wormyrocks/Harrison145/Harrison145_Antenna/Sprite-0001.png

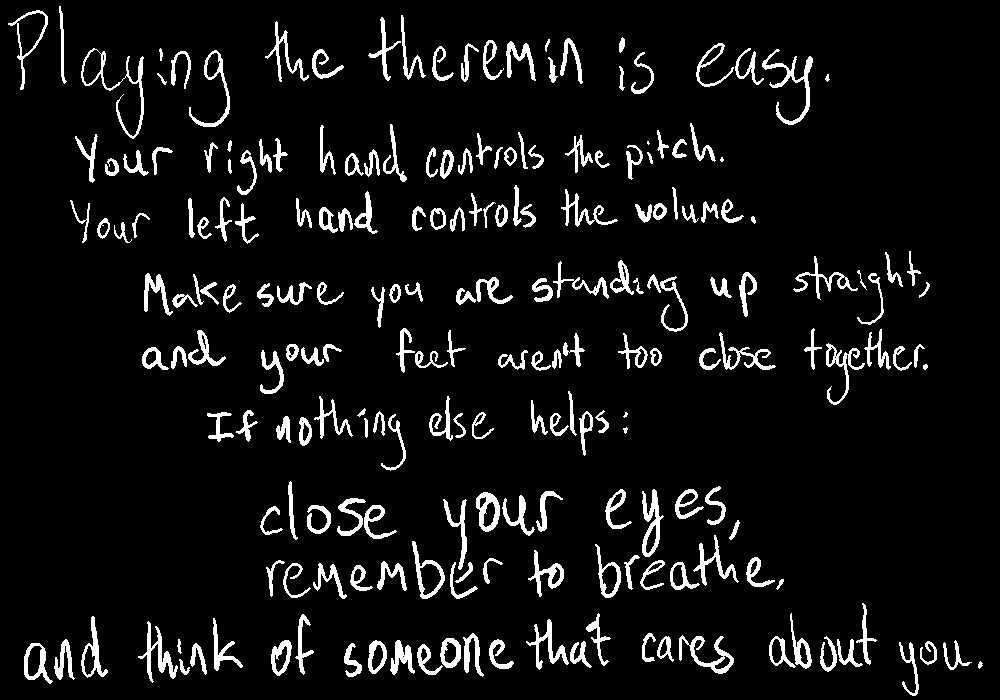
Harrison145_Antenna/Sprite-0001.png
