wormyrocks/Harrison145/ngspice/waveforms/breadboard-aircoil.png

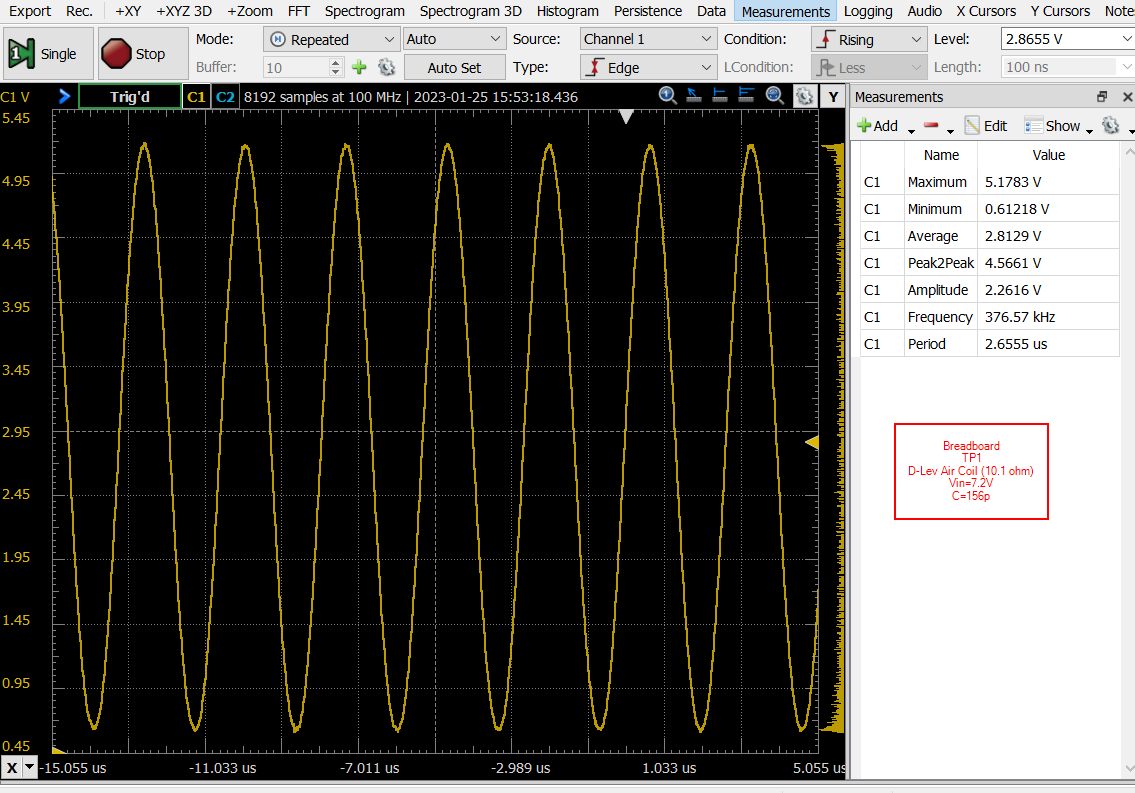
ngspice/waveforms/breadboard-aircoil.png
