wormyrocks/Harrison145/ngspice/waveforms/breadboard-coilcraft-shielded.png

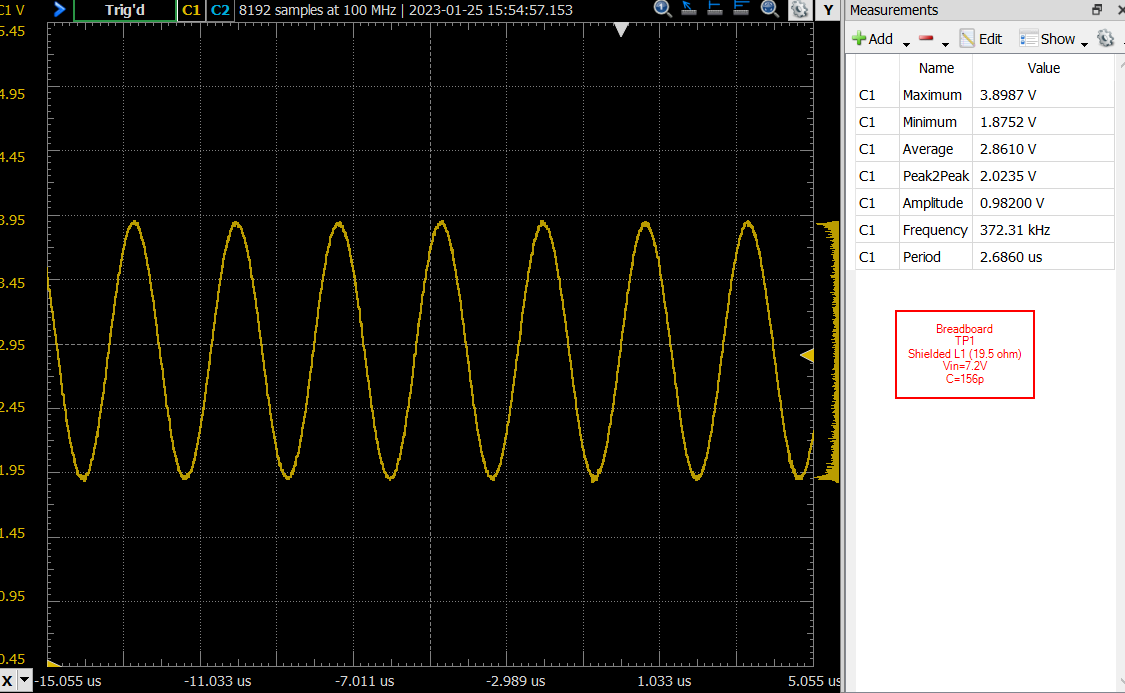
ngspice/waveforms/breadboard-coilcraft-shielded.png
