wormyrocks/Harrison145/ngspice/waveforms/pcb-coilcraft-shielded.png

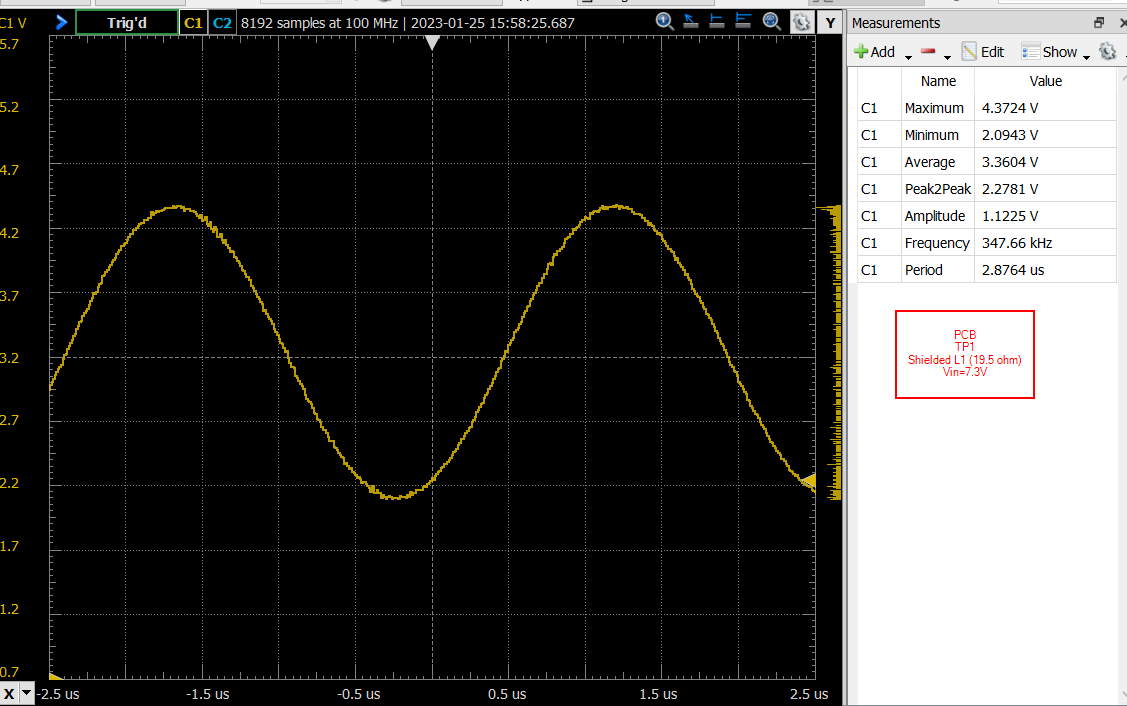
ngspice/waveforms/pcb-coilcraft-shielded.png
