wormyrocks/Harrison145/Harrison145_Main/MouserBOM.xls

Mfr Part Number (Input) | Manufacturer Part Number | Mouser Part Number | Manufacturer Name | Description | Quantity 1 | Unit Price 1 | Quantity 2 | Unit Price 2 | Quantity 3 | Unit Price 3 | Quantity 4 | Unit Price 4 | Quantity 5 | Unit Price 5 | Order Quantity | Order Unit Price | Min./Mult. | Availability | Lead Time in Days | Lifecycle | NCNR | RoHS | Pb Free | Package Type | Datasheet URL | Product Image | Design Risk
 |  | 74-TMCP1E105KTRF |  | C1, C2, C18, C30, C31, C33, C41 | 7
 |  | 80-C0603C101K8RAUTO |  | C3, C29 | 2
 |  | 80-C0603C100K3RAUTO |  | C4, C5, C15, C17, C19, C20, C26, C28 | 8
 |  | 598-MC12FA151J-F |  | C6, C16 | 2
 |  | 768-JZ400 |  | C7, C25 | 2
 |  | 80-C0603C103K2REAUTO |  | C8, C9, C11, C12, C13 | 5
 |  | 80-T489A106K10ATA2K2 |  | C10, C37, C38, C40 | 4
 |  | 5982-08-100V5.0-F |  | C14, C24 | 2
 |  | 598-MC12CD100D-TF |  | C14_TEST1, C24_TEST1 | 2
 |  | 598-MC18FD331J-TF |  | C21, C27 | 2
 |  | 80-C603C104K5RAC3121 |  | C22, C23, C34, C35 | 4
 |  | 667-EEF-KX0E221RE |  | C32, C39 | 2
 |  | 581-TACL474K010X |  | C36 | 1
 |  | 637-SM4001 |  | CR1, CR2, CR4, CR5, CR6 | 5
 |  | 512-1N914BWT |  | CR3 | 1
 |  | 710-150060GS75000 |  | D1 | 1
 |  | 807-5022R-102J |  | L1, L2, L3, L4 | 4
 |  | 726-MMBT3906LT1 |  | Q1, Q2, Q6, Q7, Q11, Q12, Q16 | 7
 |  | 106-SMP5484 |  | Q3, Q5, Q8, Q10, Q13 | 5
 |  | 726-MMBT3904LT1 |  | Q4, Q9, Q14, Q15 | 4
 |  | 603-RC0603FR-103K3L |  | R1, R24, R36 | 3
 |  | 603-RC0603FR-0722KL |  | R2, R35 | 2
 |  | 603-RC0603FR-0710KL |  | R3, R25, R37 | 3
 |  | 603-RC0603FR-07100KL |  | R4 | 1
 |  | 603-AC0603FR-074M7L |  | R5, R20, R27, R33 | 4
 |  | 603-RC0603FR-072M7L |  | R6, R21, R28, R34 | 4
 |  | 603-RC0603FR-102K2L |  | R7, R14, R15, R19, R29, R30, R31 | 7
 |  | 603-AC0603FR-071ML |  | R8, R9, R10, R39, R40, R42 | 6
 |  | 603-RC0603FR-0710KL |  | R11, R17 | 2
 |  | 603-RC0603FR-13150KL |  | R12 | 1
 |  | 603-RC0603FR-07100KL |  | R13, R23, R38, R41, R44, R48, R55 | 7
 |  | 603-RC0603FR-071KP |  | R16, R58 | 2
 |  | 603-RC0603FR-13220KL |  | R18 | 1
 |  | 603-RC0603FR-0722KL |  | R22, R49, R52 | 3
 |  | 603-RC0603FR-0768KL |  | R26 | 1
 |  | 603-RC0603FR-1333KL |  | R32, R45 | 2
 |  | 603-RC0603FR-07680RL |  | R43 | 1
 |  | 603-RC0603FR-13220RL |  | R46 | 1
 |  | 603-RC0603FR-1333RL |  | R47 | 1
 |  | 603-RC0603FR-104K7L |  | R50, R51 | 2
 |  | 603-SR0603FR-7T10RL |  | R53, R54 | 2
 |  | 603-RC0603FR-103K3L |  | R56 | 1
 |  | 603-RC0603FR-073K92L |  | R57 | 1
 |  | 652-PTV09A-3015FB103 |  | RV1, RV2 | 2
 |  | 534-5002 |  | TP1, TP2, TP3, TP4, TP5, TP6, TP7, TP8 | 8
 |  | 511-LDK320M-R |  | U1 | 1
 |  | 511-LDK320M-R |  | U1 | 1
