wormyrocks/Harrison145/Harrison145_Antenna/Harrison145_Antenna.kicad_pcb

## KiCad design Harrison145_Antenna/Harrison145_Antenna.kicad_pcb (2023-02-07)

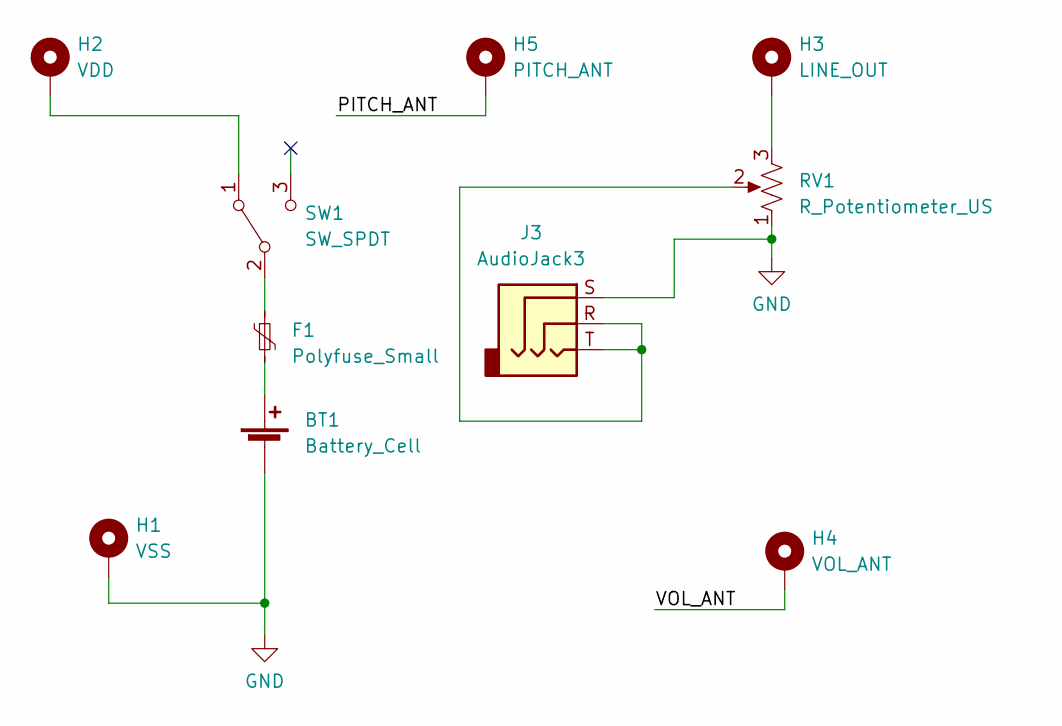
[picture p5: schematic Harrison145_Antenna.kicad_sch]

Parts:
BT1: Battery_Cell; 9V_Bat
F1: Polyfuse_Small; Fuse_1812_4532Metric_Pad1.30x3.40mm_HandSolder
H1: VSS; SMTSO-M4
H2: VDD; SMTSO-M4
H3: LINE_OUT; SMTSO-M4
H4: VOL_ANT; SMTSO-M4
H5: PITCH_ANT; SMTSO-M4
J3: AudioJack3; Jack_3.5mm_CUI_SJ-3523-SMT_Horizontal
RV1: R_Potentiometer_US; PTV09A3015FB103
SW1: SW_SPDT; CSS1210TB

Connections:
/PITCH_ANT: H5.1
/VOL_ANT: H4.1
GND: BT1.2 (-), H1.1, J3.S, RV1.1
unnamed: BT1.1 (+), F1.2
unnamed: H3.1, RV1.3
unnamed: J3.R, J3.T, RV1.2
unnamed: H2.1, SW1.1 (A)
unnamed: F1.1, SW1.2 (B)

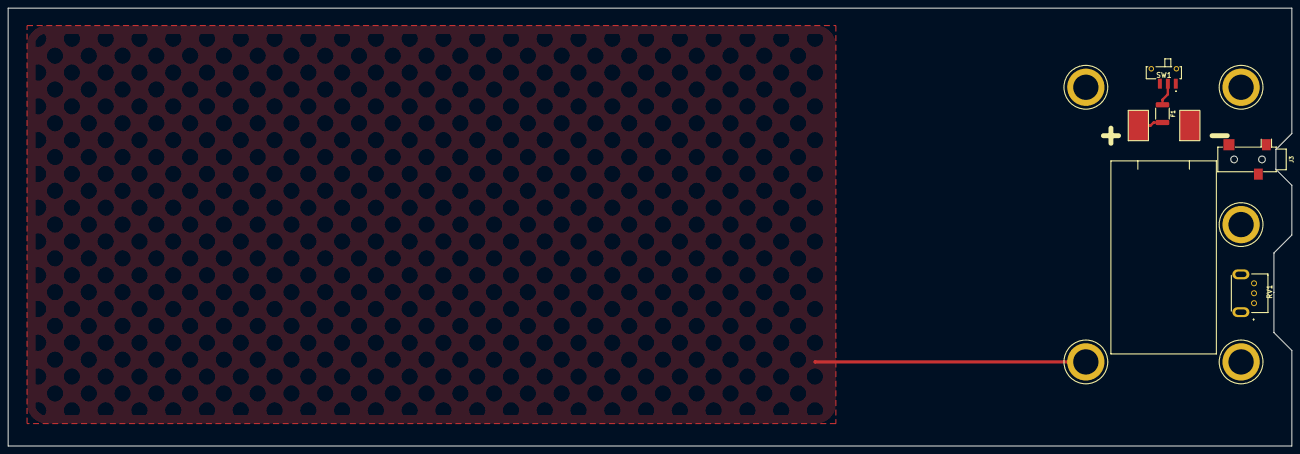
[picture p6: board Harrison145_Antenna.kicad_pcb from above]

Board: 2 copper layers, 322.5 x 110.0 mm, 10 parts (0 on the bottom side), 6 nets.
