wormyrocks/Harrison145/Harrison145_Main_Rev2/Harrison145.kicad_pcb

## KiCad design Harrison145_Main_Rev2/Harrison145.kicad_pcb (2023-01-10)

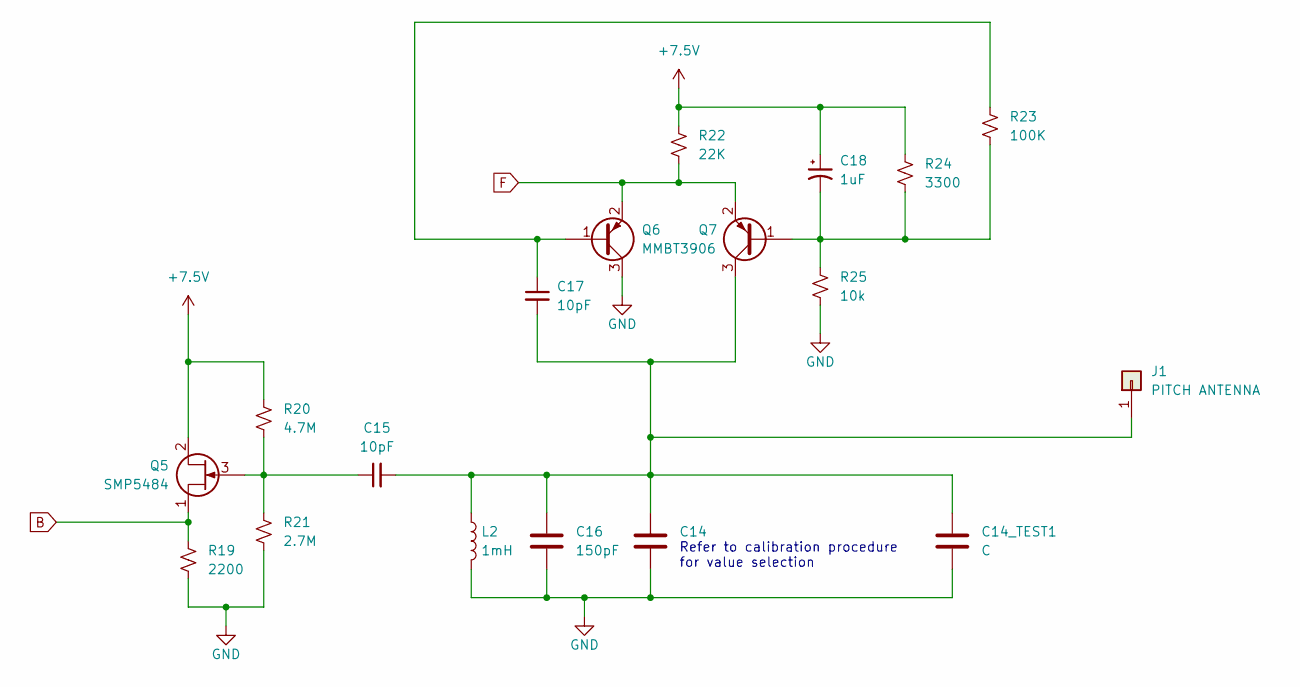
[picture p7: schematic VarOsc.kicad_sch]

Parts:
C14: C_Mica; C_0805_2012Metric_Pad1.18x1.45mm_HandSolder
C14_TEST1: C; C_Disc_D3.0mm_W1.6mm_P2.50mm
C15, C17: 10pF; C_0603_1608Metric
C16: 150pF; C_1210_3225Metric_Pad1.33x2.70mm_HandSolder
C18: 1uF; CP_EIA-2012-12_Kemet-R_Pad1.30x1.05mm_HandSolder
J1: PITCH ANTENNA; MountingHole_4.3mm_M4_Pad_Via
L2: 1mH; L_1812_4532Metric
Q5: SMP5484; SOT-23
Q6, Q7: MMBT3906; SOT-23
R19: 2200; R_0603_1608Metric
R20: 4.7M; R_0603_1608Metric
R21: 2.7M; R_0603_1608Metric
R22: 22K; R_0603_1608Metric
R23: 100K; R_0603_1608Metric
R24: 3300; R_0603_1608Metric
R25: 10k; R_0603_1608Metric

Connections:
+7.5V: C18.1, Q5.2 (D), R20.1, R22.1, R24.1; also elsewhere on the board
B: Q5.1 (S), R19.1; also elsewhere on the board
F: Q6.2 (E), Q7.2 (E), R22.2; also elsewhere on the board
GND: C14.2, C14_TEST1.2, C16.2, L2.2, Q6.3 (C), R19.2, R21.2, R25.2; also elsewhere on the board
unnamed: C14.1, C14_TEST1.1, C15.2, C16.1, C17.2, J1.1, L2.1, Q7.3 (C)
unnamed: C15.1, Q5.3 (G), R20.2, R21.1
unnamed: C17.1, Q6.1 (B), R23.1
unnamed: C18.2, Q7.1 (B), R23.2, R24.2, R25.1

Notes on the sheet:
Refer to calibration procedure for value selection

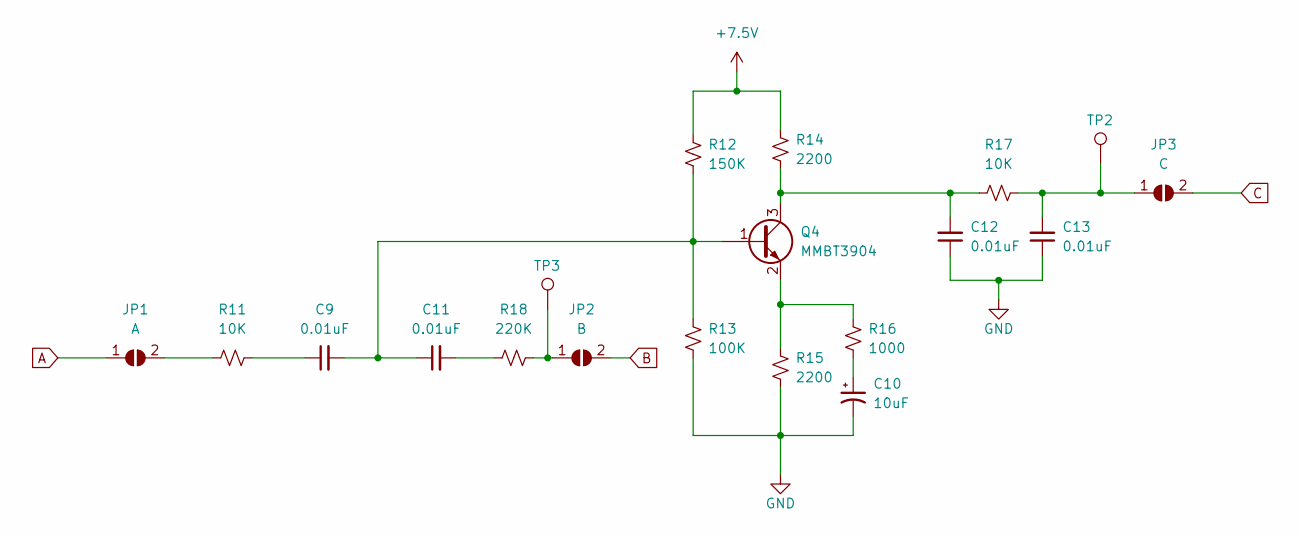
[picture p8: schematic mixer.kicad_sch]

Parts:
C9, C11, C12, C13: 0.01uF; C_0603_1608Metric
C10: 10uF; CP_EIA-3216-18_Kemet-A
JP1: A; SolderJumper-2_P1.3mm_Open_RoundedPad1.0x1.5mm
JP2: B; SolderJumper-2_P1.3mm_Open_RoundedPad1.0x1.5mm
JP3: C; SolderJumper-2_P1.3mm_Open_RoundedPad1.0x1.5mm
Q4: MMBT3904; SOT-23
R11, R17: 10K; R_0603_1608Metric
R12: 150K; R_0603_1608Metric
R13: 100K; R_0603_1608Metric
R14, R15: 2200; R_0603_1608Metric
R16: 1000; R_0603_1608Metric
R18: 220K; R_0603_1608Metric
TP2, TP3: TestPoint; TestPoint_Loop_D1.80mm_Drill1.0mm_Beaded

Connections:
+7.5V: R12.2, R14.2; also elsewhere on the board
A: JP1.1 (A); also elsewhere on the board
B: JP2.2 (B); also elsewhere on the board
C: JP3.2 (B); also elsewhere on the board
GND: C10.2, C12.1, C13.1, R13.1, R15.1; also elsewhere on the board
unnamed: C9.1, R11.2
unnamed: C10.1, R16.1
unnamed: C11.2, R18.1
unnamed: JP1.2 (B), R11.1
unnamed: JP2.1 (A), R18.2, TP3.1
unnamed: C13.2, JP3.1 (A), R17.2, TP2.1
unnamed: C9.2, C11.1, Q4.1 (B), R12.1, R13.2
unnamed: C12.2, Q4.3 (C), R14.1, R17.1
unnamed: Q4.2 (E), R15.2, R16.2

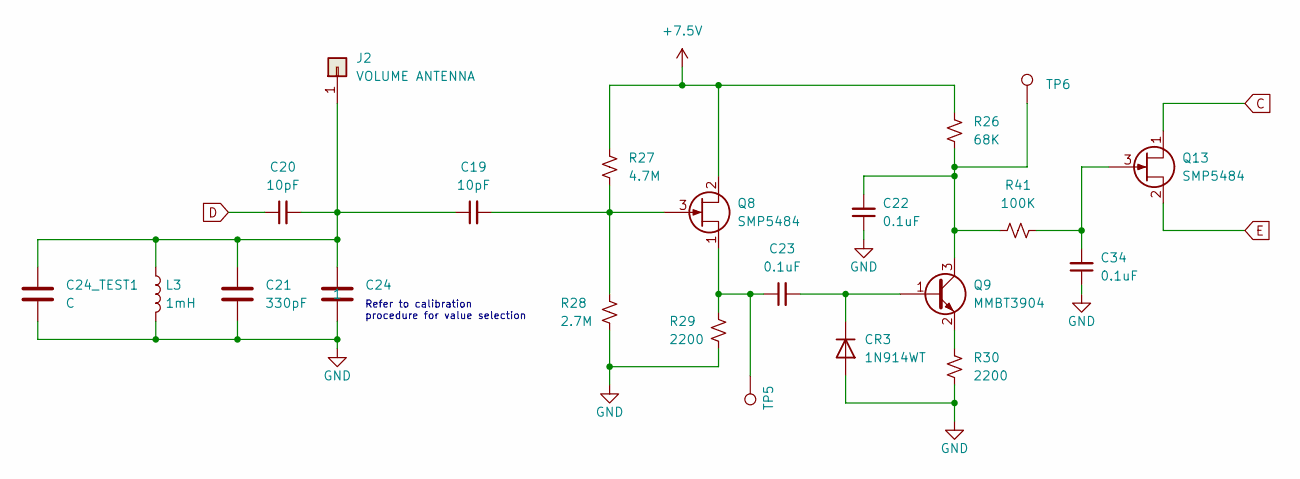
[picture p9: schematic VolProcessor.kicad_sch]

Parts:
C19, C20: 10pF; C_0603_1608Metric
C21: 330pF; C_1812_4532Metric_Pad1.57x3.40mm_HandSolder
C22, C23, C34: 0.1uF; C_0603_1608Metric
C24: C_Mica; C_0805_2012Metric_Pad1.18x1.45mm_HandSolder
C24_TEST1: C; C_Disc_D3.0mm_W1.6mm_P2.50mm
CR3: 1N914WT; D_SOD-523
J2: VOLUME ANTENNA; MountingHole_4.3mm_M4_Pad_Via
L3: 1mH; L_1812_4532Metric
Q8, Q13: SMP5484; SOT-23
Q9: MMBT3904; SOT-23
R26: 68K; R_0603_1608Metric
R27: 4.7M; R_0603_1608Metric
R28: 2.7M; R_0603_1608Metric
R29, R30: 2200; R_0603_1608Metric
R41: 100K; R_0603_1608Metric
TP5, TP6: TestPoint; TestPoint_Loop_D1.80mm_Drill1.0mm_Beaded

Connections:
+7.5V: Q8.2 (D), R26.1, R27.1; also elsewhere on the board
C: Q13.1 (S); also elsewhere on the board
D: C20.1; also elsewhere on the board
E: Q13.2 (D); also elsewhere on the board
GND: C21.2, C22.1, C24.2, C24_TEST1.2, C34.1, CR3.2 (A), L3.2, R28.2, R29.2, R30.2; also elsewhere on the board
unnamed: C23.2, CR3.1 (K), Q9.1 (B)
unnamed: C19.1, C20.2, C21.1, C24.1, C24_TEST1.1, J2.1, L3.1
unnamed: C19.2, Q8.3 (G), R27.2, R28.1
unnamed: C23.1, Q8.1 (S), R29.1, TP5.1
unnamed: C22.2, Q9.3 (C), R26.2, R41.1, TP6.1
unnamed: Q9.2 (E), R30.1
unnamed: C34.2, Q13.3 (G), R41.2

Notes on the sheet:
Refer to calibration procedure for value selection

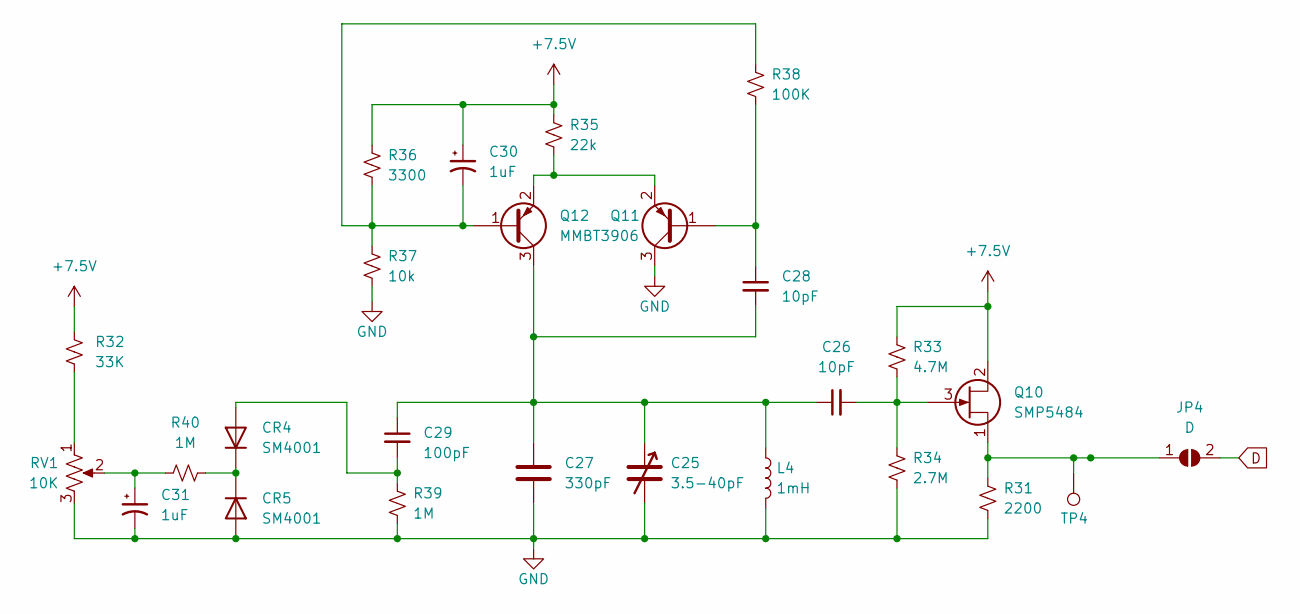
[picture p10: schematic VolOsc.kicad_sch]

Parts:
C25: 3.5-40pF; CAPV_JZ400
C26, C28: 10pF; C_0603_1608Metric
C27: 330pF; C_1812_4532Metric_Pad1.57x3.40mm_HandSolder
C29: 100pF; C_0603_1608Metric
C30, C31: 1uF; CP_EIA-2012-12_Kemet-R_Pad1.30x1.05mm_HandSolder
CR4, CR5: SM4001; D_MELF
JP4: D; SolderJumper-2_P1.3mm_Open_RoundedPad1.0x1.5mm
L4: 1mH; L_1812_4532Metric
Q10: SMP5484; SOT-23
Q11, Q12: MMBT3906; SOT-23
R31: 2200; R_0603_1608Metric
R32: 33K; R_0603_1608Metric
R33: 4.7M; R_0603_1608Metric
R34: 2.7M; R_0603_1608Metric
R35: 22k; R_0603_1608Metric
R36: 3300; R_0603_1608Metric
R37: 10k; R_0603_1608Metric
R38: 100K; R_0603_1608Metric
R39, R40: 1M; R_0603_1608Metric
RV1: 10K; PTV09A3015FB103
TP4: TestPoint; TestPoint_Loop_D1.80mm_Drill1.0mm_Beaded

Connections:
+7.5V: C30.1, Q10.2 (D), R32.1, R33.1, R35.2, R36.1; also elsewhere on the board
D: JP4.2 (B); also elsewhere on the board
GND: C25.2, C27.2, C31.2, CR5.2 (A), L4.2, Q11.3 (C), R31.2, R34.2, R37.2, R39.2, RV1.3; also elsewhere on the board
unnamed: C31.1, R40.1, RV1.2
unnamed: C29.2, CR4.2 (A), R39.1
unnamed: CR4.1 (K), CR5.1 (K), R40.2
unnamed: JP4.1 (A), Q10.1 (S), R31.1, TP4.1
unnamed: C26.2, Q10.3 (G), R33.2, R34.1
unnamed: C28.1, Q11.1 (B), R38.2
unnamed: Q11.2 (E), Q12.2 (E), R35.1
unnamed: C30.2, Q12.1 (B), R36.2, R37.1, R38.1
unnamed: C25.1, C26.1, C27.1, C28.2, C29.1, L4.1, Q12.3 (C)
unnamed: R32.2, RV1.1

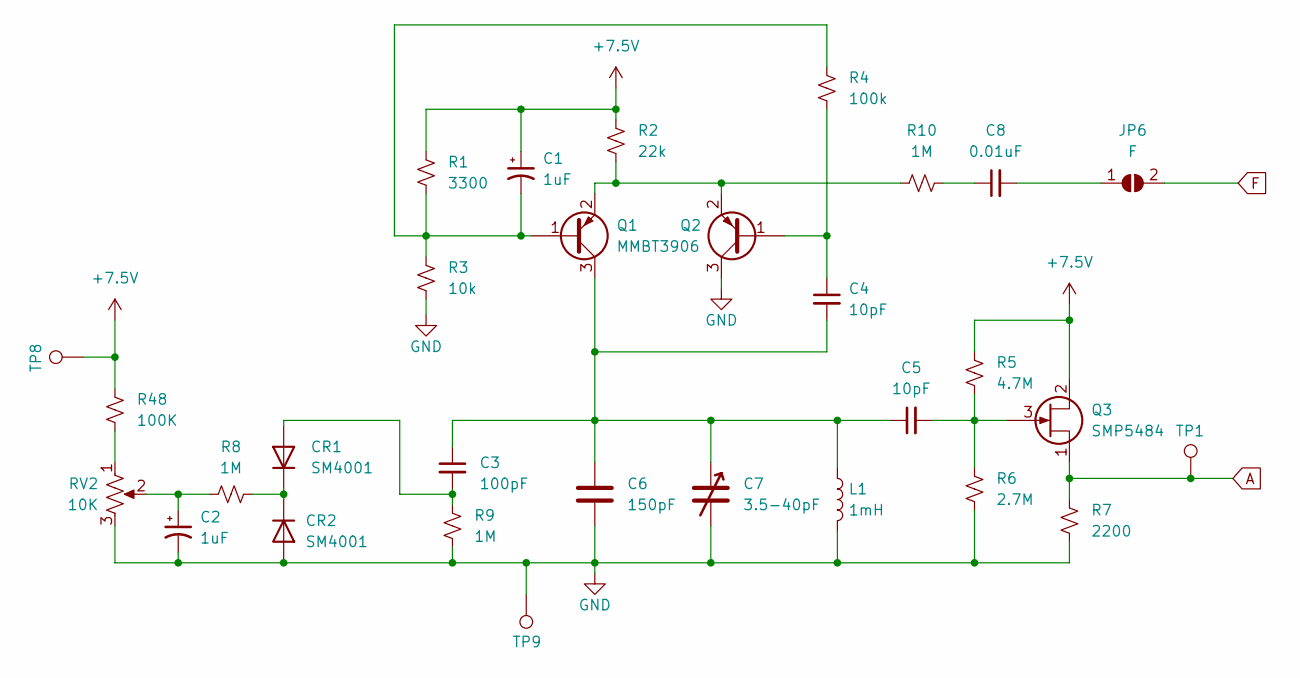
[picture p11: schematic pitch_osc.kicad_sch]

Parts:
C1, C2: 1uF; CP_EIA-2012-12_Kemet-R_Pad1.30x1.05mm_HandSolder
C3: 100pF; C_0603_1608Metric
C4, C5: 10pF; C_0603_1608Metric
C6: 150pF; C_1210_3225Metric_Pad1.33x2.70mm_HandSolder
C7: 3.5-40pF; CAPV_JZ400
C8: 0.01uF; C_0603_1608Metric
CR1, CR2: SM4001; D_MELF
JP6: F; SolderJumper-2_P1.3mm_Open_RoundedPad1.0x1.5mm
L1: 1mH; L_1812_4532Metric
Q1, Q2: MMBT3906; SOT-23
Q3: SMP5484; SOT-23
R1: 3300; R_0603_1608Metric
R2: 22k; R_0603_1608Metric
R3: 10k; R_0603_1608Metric
R4: 100k; R_0603_1608Metric
R5: 4.7M; R_0603_1608Metric
R6: 2.7M; R_0603_1608Metric
R7: 2200; R_0603_1608Metric
R8, R9, R10: 1M; R_0603_1608Metric
R48: 100K; R_0603_1608Metric
RV2: 10K; PTV09A3015FB103
TP1, TP8, TP9: TestPoint; TestPoint_Loop_D1.80mm_Drill1.0mm_Beaded

Connections:
+7.5V: C1.1, Q3.2 (D), R1.1, R2.2, R5.1, R48.1, TP8.1; also elsewhere on the board
A: Q3.1 (S), R7.1, TP1.1; also elsewhere on the board
F: JP6.2 (B); also elsewhere on the board
GND: C2.2, C6.2, C7.2, CR2.2 (A), L1.2, Q2.3 (C), R3.2, R6.2, R7.2, R9.2, RV2.3, TP9.1; also elsewhere on the board
unnamed: C2.1, R8.1, RV2.2
unnamed: C8.1, R10.2
unnamed: C3.2, CR1.2 (A), R9.1
unnamed: CR1.1 (K), CR2.1 (K), R8.2
unnamed: C8.2, JP6.1 (A)
unnamed: C1.2, Q1.1 (B), R1.2, R3.1, R4.1
unnamed: C3.1, C4.2, C5.1, C6.1, C7.1, L1.1, Q1.3 (C)
unnamed: Q1.2 (E), Q2.2 (E), R2.1, R10.1
unnamed: C4.1, Q2.1 (B), R4.2
unnamed: C5.2, Q3.3 (G), R5.2, R6.1
unnamed: R48.2, RV2.1

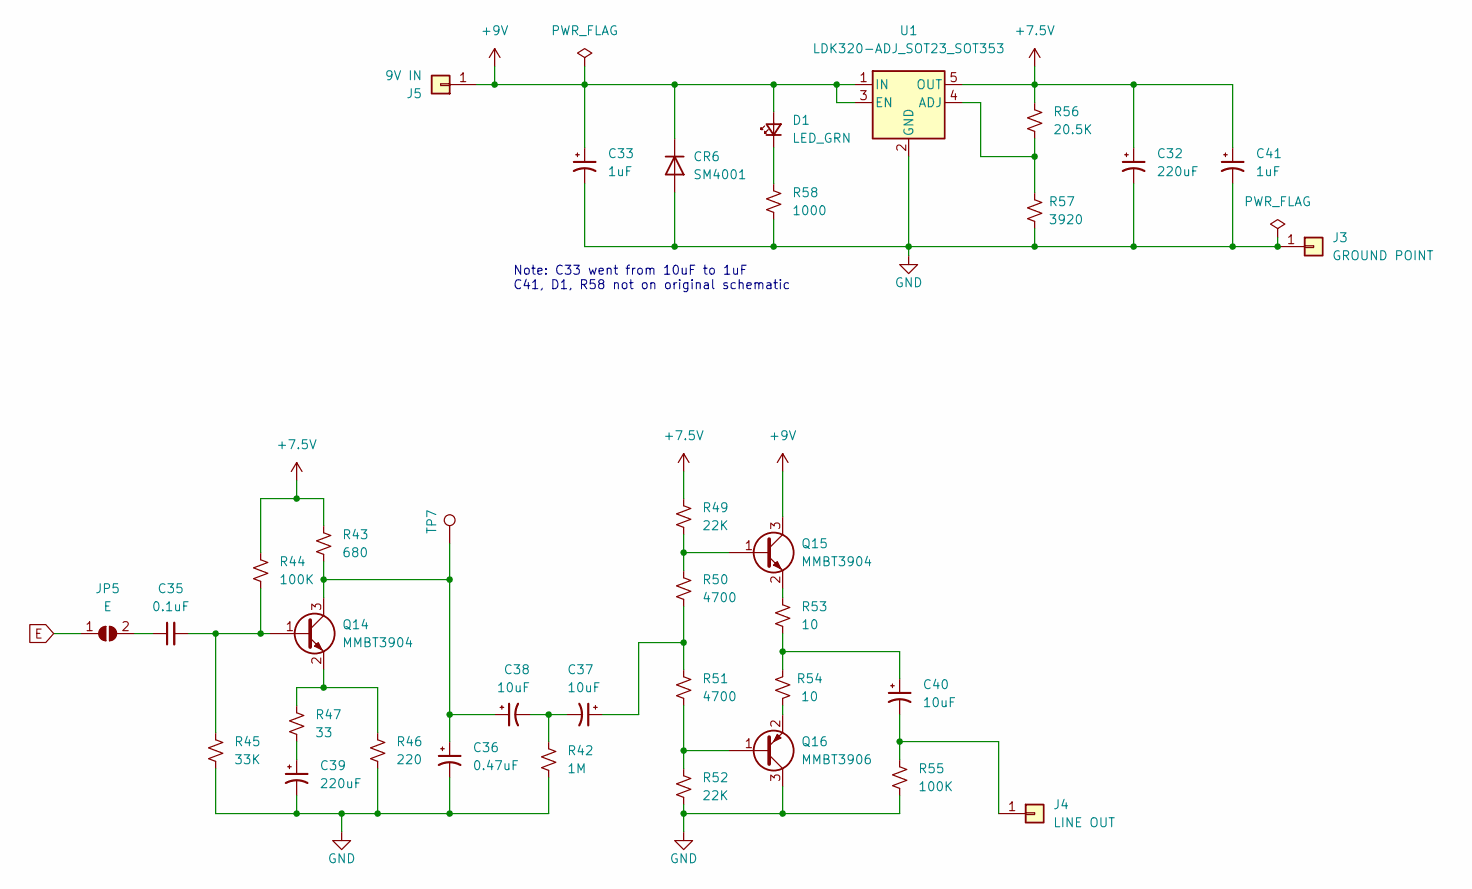
[picture p12: schematic AudioAmpVreg.kicad_sch]

Parts:
C32, C39: 220uF; CP_Elec_6.3x5.9
C33, C41: 1uF; CP_EIA-2012-12_Kemet-R_Pad1.30x1.05mm_HandSolder
C35: 0.1uF; C_0603_1608Metric
C36: 0.47uF; CP_EIA-1608-08_AVX-J
C37, C38, C40: 10uF; CP_EIA-3216-18_Kemet-A
CR6: SM4001; D_MELF
D1: LED_GRN; LED_0603_1608Metric_Pad1.05x0.95mm_HandSolder
J3: GROUND POINT; MountingHole_4.3mm_M4_Pad_Via
J4: LINE OUT; MountingHole_4.3mm_M4_Pad_Via
J5: 9V IN; MountingHole_4.3mm_M4_Pad_Via
JP5: E; SolderJumper-2_P1.3mm_Open_RoundedPad1.0x1.5mm
Q14, Q15: MMBT3904; SOT-23
Q16: MMBT3906; SOT-23
R42: 1M; R_0603_1608Metric
R43: 680; R_0603_1608Metric
R44, R55: 100K; R_0603_1608Metric
R45: 33K; R_0603_1608Metric
R46: 220; R_0603_1608Metric
R47: 33; R_0603_1608Metric
R49, R52: 22K; R_0603_1608Metric
R50, R51: 4700; R_0603_1608Metric
R53, R54: 10; R_0603_1608Metric
R56: 20.5K; R_0603_1608Metric
R57: 3920; R_0603_1608Metric
R58: 1000; R_0603_1608Metric
TP7: TestPoint; TestPoint_Loop_D1.80mm_Drill1.0mm_Beaded
U1: LDK320-ADJ_SOT23_SOT353; SOT-23-5

Connections:
+7.5V: C32.1, C41.1, R43.2, R44.1, R49.1, R56.1, U1.5 (OUT); also elsewhere on the board
+9V: C33.1, CR6.1 (K), D1.2 (A), J5.1, Q15.3 (C), U1.1 (IN), U1.3 (EN)
E: JP5.1 (A); also elsewhere on the board
GND: C32.2, C33.2, C36.2, C39.2, C41.2, CR6.2 (A), J3.1, Q16.3 (C), R42.2, R45.2, R46.2, R52.2, R55.2, R57.2, R58.2, U1.2 (GND); also elsewhere on the board
unnamed: C37.1, R50.2, R51.2
unnamed: C37.2, C38.2, R42.1
unnamed: C39.1, R47.2
unnamed: C40.1, R53.1, R54.2
unnamed: D1.1 (K), R58.1
unnamed: C40.2, J4.1, R55.1
unnamed: C35.1, JP5.2 (B)
unnamed: C35.2, Q14.1 (B), R44.2, R45.1
unnamed: C36.1, C38.1, Q14.3 (C), R43.1, TP7.1
unnamed: Q14.2 (E), R46.1, R47.1
unnamed: Q15.1 (B), R49.2, R50.1
unnamed: Q15.2 (E), R53.2
unnamed: Q16.1 (B), R51.1, R52.1
unnamed: Q16.2 (E), R54.1
unnamed: R56.2, R57.1, U1.4 (ADJ)

Notes on the sheet:
Note: C33 went from 10uF to 1uF C41, D1, R58 not on original schematic

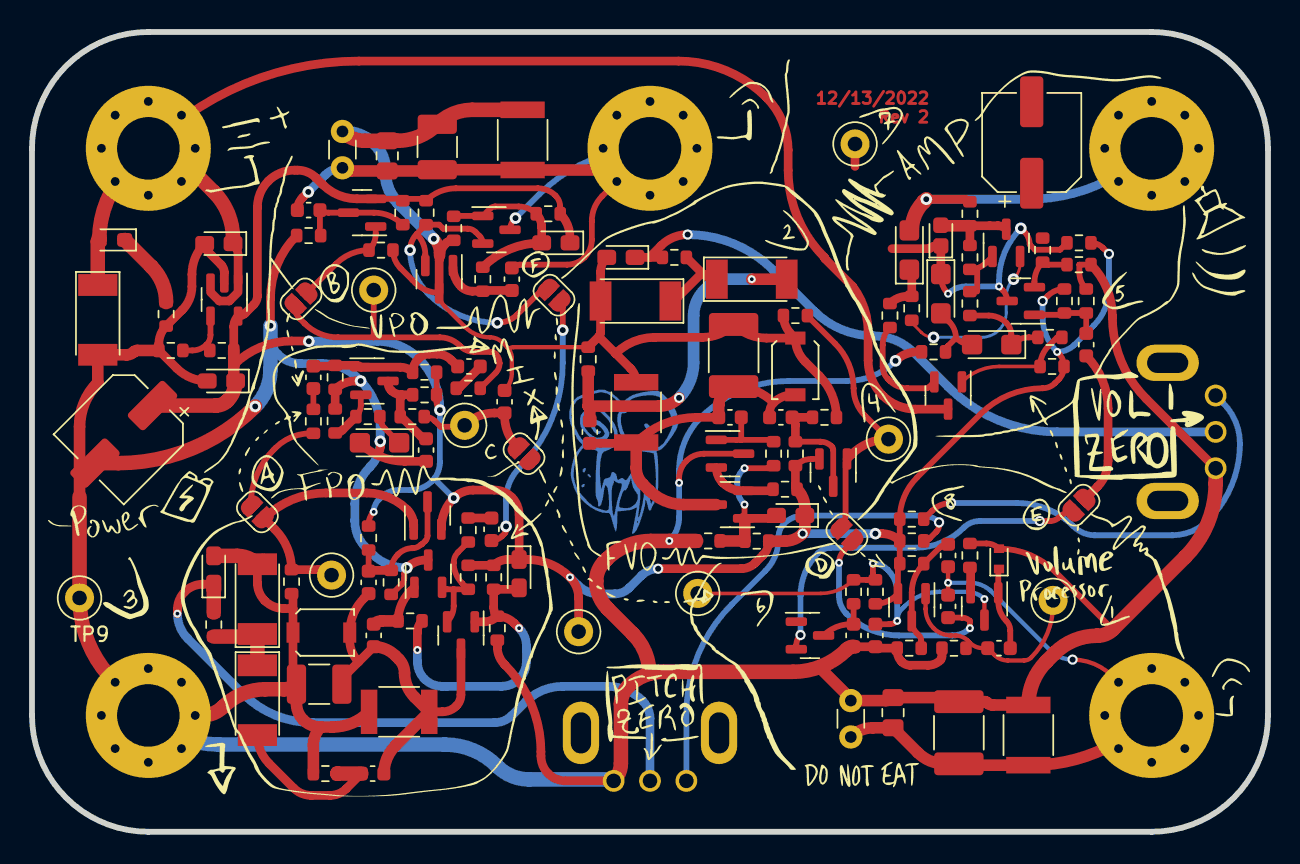
[picture p13: board Harrison145.kicad_pcb from above]

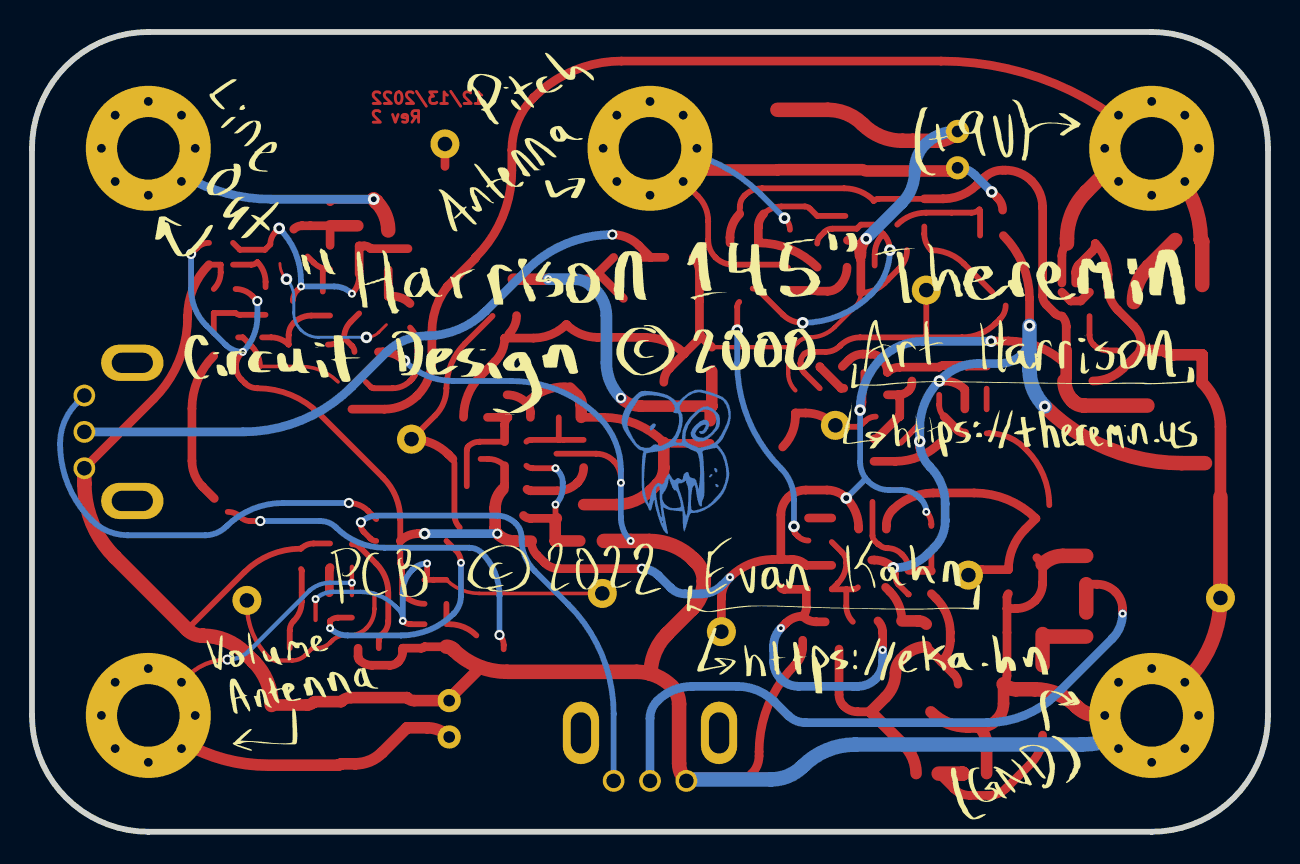
[picture p14: board Harrison145.kicad_pcb from below]

Board: 2 copper layers, 85.0 x 55.0 mm, 152 parts (2 on the bottom side), 65 nets.

Other parts of the board:
Ge: LOGO; FrontSilk
