wormyrocks/Harrison145/(commit log)

2022-12-08 Components mostly placed
    [AudioAmpVreg.kicad_sch, Harrison145.kicad_pcb, Harrison145.kicad_sch, VarOsc.kicad_sch, VolOsc.kicad_sch, VolProcessor.kicad_sch, mixer.kicad_sch, pitch_osc.kicad_sch]
2022-12-10 Better component placements
    [AudioAmpVreg.kicad_sch, Harrison145.kicad_pcb, Harrison145.kicad_sch, VarOsc.kicad_sch, VolOsc.kicad_sch, VolProcessor.kicad_sch, mixer.kicad_sch, pitch_osc.kicad_sch]
2022-12-11 Mostly routed
    [Harrison145.kicad_pcb]
2022-12-12 Routing finished, still needs to pass DRC
    [AudioAmpVreg.kicad_sch, Harrison145.kicad_pcb]
2022-12-12 Improved DRC
    [Harrison145.kicad_pcb]
2022-12-12 Reduced silk designators; DRC passes
    [Harrison145.kicad_pcb]
2022-12-13 Added aseprite backgrounds
    [Harrison145.kicad_pcb]
2022-12-13 All DRC/ERC that matters passes
    [Harrison145.kicad_pcb]
2022-12-13 Added mouser part links
    [AudioAmpVreg.kicad_sch, VarOsc.kicad_sch, VolOsc.kicad_sch, VolProcessor.kicad_sch, mixer.kicad_sch, pitch_osc.kicad_sch]
2022-12-13 Added BOM and Mouser BOM
    [Harrison145.csv, MouserBOM.xls]
2022-12-13 Added revision number
    [Harrison145.kicad_pcb]
2022-12-14 antenna outline
2022-12-14 Added iBOM
    [Harrison145.kicad_pcb, VarOsc.kicad_sch, VolProcessor.kicad_sch]
2022-12-14 Added antenna project
    [AudioAmpVreg.kicad_sch, Harrison145.csv, Harrison145.kicad_pcb, Harrison145.kicad_sch, Harrison145_Antenna.kicad_pcb, Harrison145_Antenna.kicad_sch, MouserBOM.xls, VarOsc.kicad_sch]
2023-01-08 Initial commit for rev2 main pcb
    * Thicken up some ground traces
    * Change to Coilcraft inductors
    * Change to aluminum polymer caps
    * Update project to KiCAD 6.99 format
    [AudioAmpVreg.kicad_sch, Harrison145.kicad_pcb, Harrison145.kicad_sch, VarOsc.kicad_sch, VolOsc.kicad_sch, VolProcessor.kicad_sch, mixer.kicad_sch, pitch_osc.kicad_sch]
2023-01-09 Update rev2 kicad_pcb
    [Harrison145.kicad_pcb]
2023-01-09 Antenna design changes
    [Harrison145_Antenna.kicad_pcb, Harrison145_Antenna.kicad_sch]
2023-01-09 Combine 9V battery and terminals into a single footprint
    [Harrison145_Antenna.kicad_pcb, Harrison145_Antenna.kicad_sch]
2023-01-10 Small updates
    * Edited Errata
    * Changed VReg resistor from 20k to 20.5k
    * Changed ceramic cap symbols incorrectly listed as polarized
    [AudioAmpVreg.kicad_sch, Harrison145.kicad_pcb, VolOsc.kicad_sch, pitch_osc.kicad_sch]
2023-01-11 Progress on bringup of simulations in KiCAD 6 and KiCAD 7
    [AudioAmpVreg.kicad_sch, Harrison145.kicad_sch, VarOsc.kicad_sch, VolOsc.kicad_sch, VolProcessor.kicad_sch, mixer.kicad_sch, pitch_osc.kicad_sch]
2023-01-19 Added FVO, other minor fixes
    * Add some to-dos
    * Add missing R9
    * Add hand capacitance to VPO
2023-01-20 'Interference pattern' antenna design
    [Harrison145_Antenna.kicad_pcb]
2023-01-20 Added step files for full antenna assembly
    [Harrison145_Antenna.kicad_pcb]
2023-01-25 Remove kicad sims
    [Harrison145.kicad_sch, Harrison145_Antenna.kicad_pcb, pitch_osc.kicad_sch]
2023-02-07 Cutouts on antenna pcb
    [Harrison145_Antenna.kicad_pcb, Harrison145_Antenna.kicad_sch]
2023-02-08 Silk and copper art
    [Harrison145_Antenna.kicad_sch]
2023-02-11 Antenna ordered from JLCPCB
    [Harrison145_Antenna.kicad_sch]
